rabbaniputrowi-alt/Mp3-player-Tamagothci-Companion/Tamagotchi Code/Tamagotchi Bee/previews/contact_sheet.png

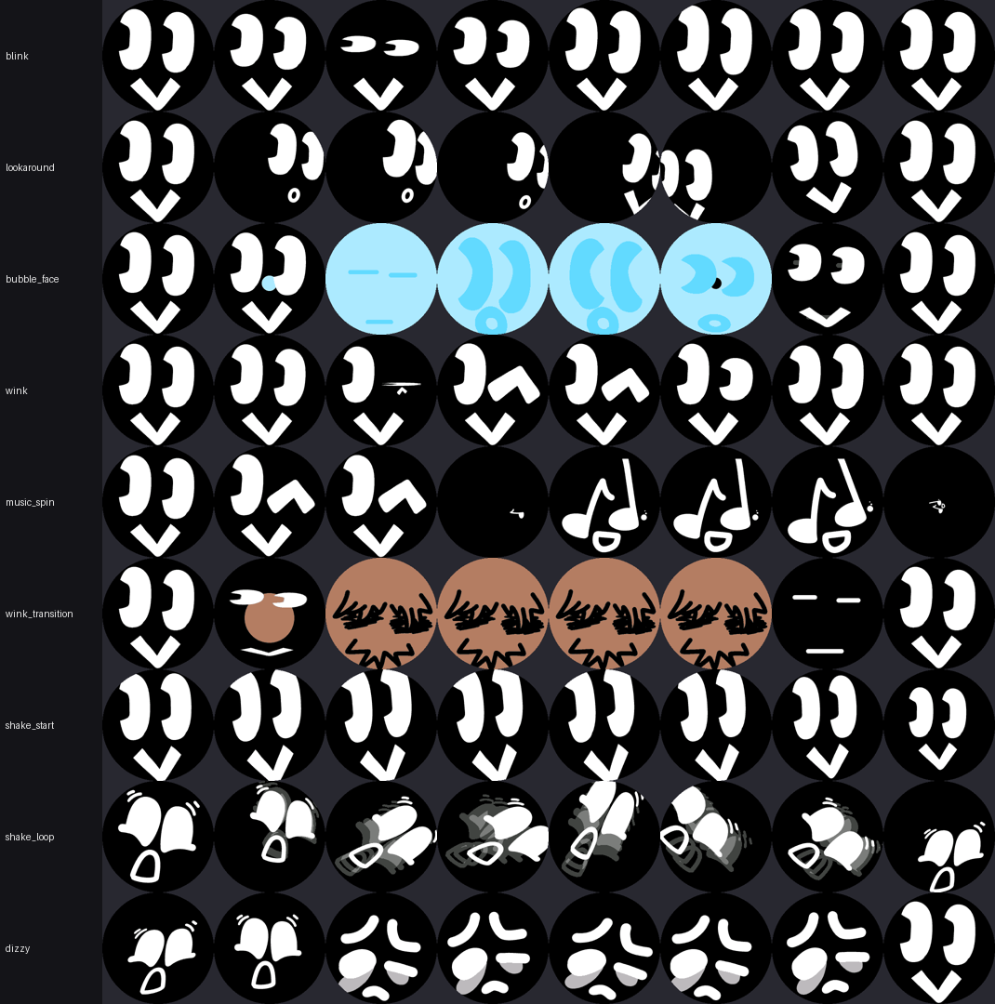
Tamagotchi Code/Tamagotchi Bee/previews/contact_sheet.png
