rabbaniputrowi-alt/Mp3-player-Tamagothci-Companion/Tamagotchi Code/TFT_folder/Spinning Disc/covers/Black_Parade.jpg

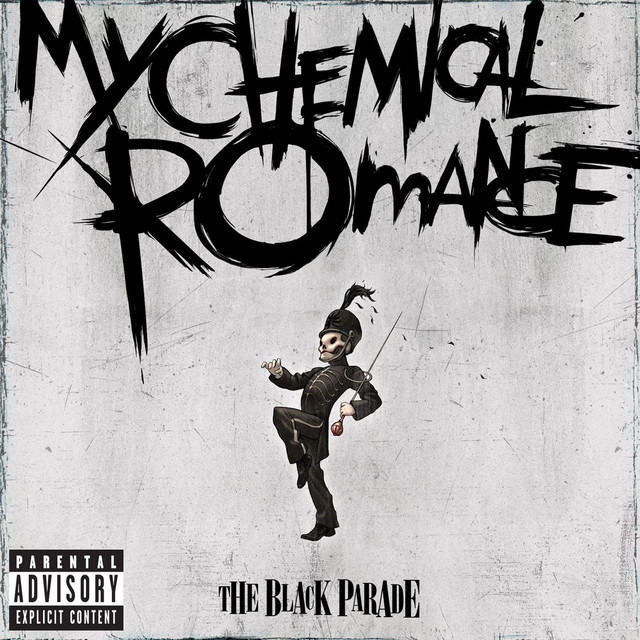
Tamagotchi Code/TFT_folder/Spinning Disc/covers/Black_Parade.jpg
