rabbaniputrowi-alt/Mp3-player-Tamagothci-Companion/Tamagotchi Code/TFT_folder/Spinning Disc/covers/Sweet_Revenge.jpg

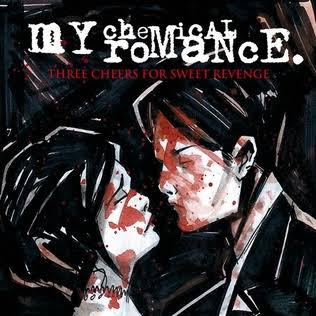
Tamagotchi Code/TFT_folder/Spinning Disc/covers/Sweet_Revenge.jpg
