rabbaniputrowi-alt/Mp3-player-Tamagothci-Companion/tools/Pet_Pipeline/clips/Penguin.gif

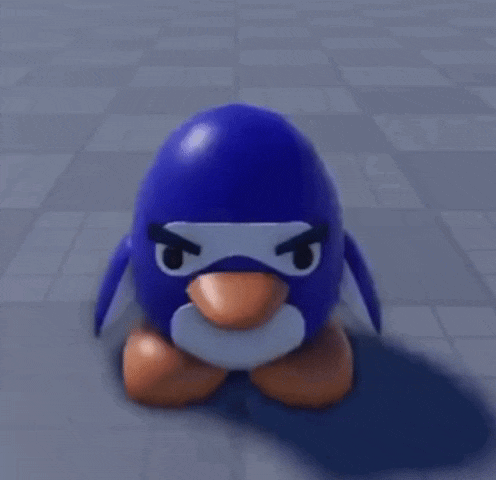
tools/Pet_Pipeline/clips/Penguin.gif
