rabbaniputrowi-alt/Mp3-player-Tamagothci-Companion/tools/previews/contact_sheet.png

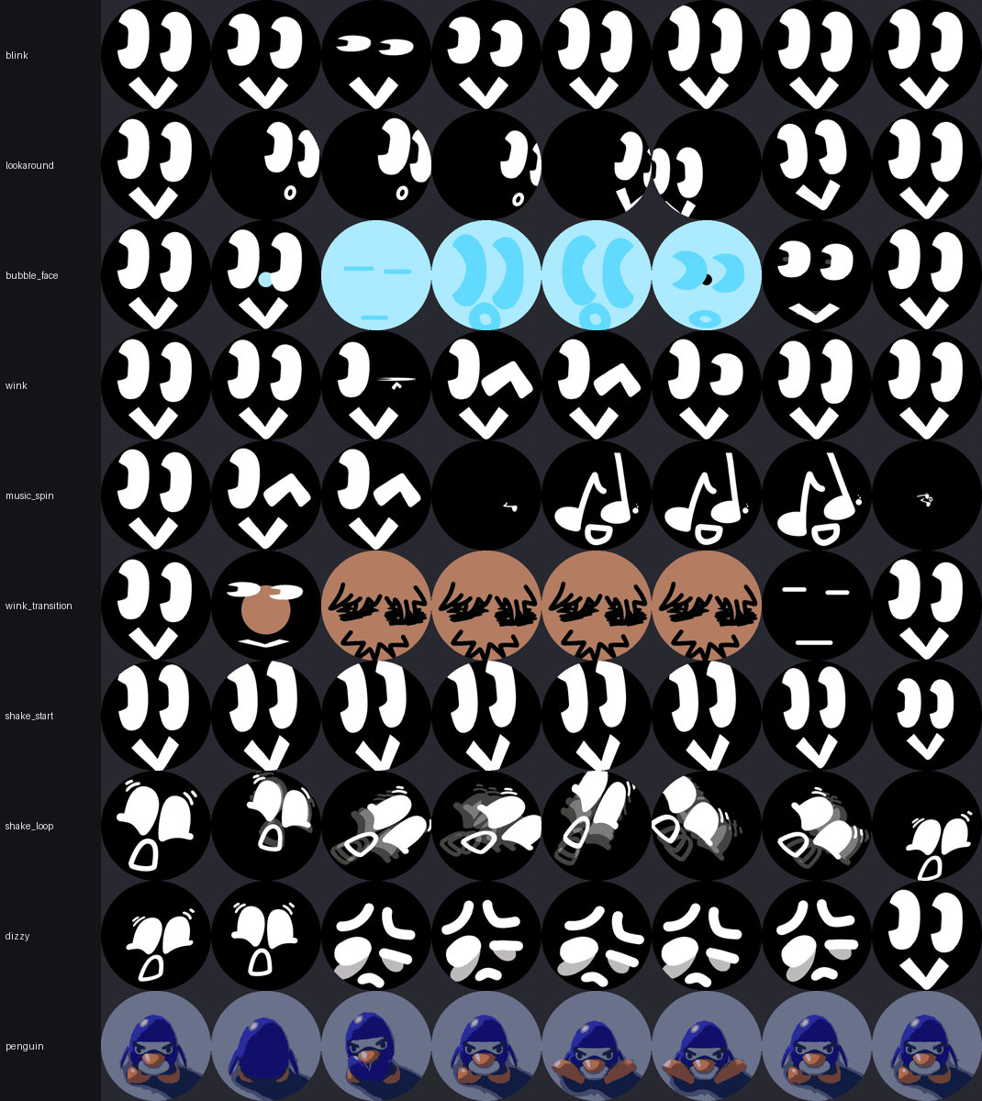
tools/previews/contact_sheet.png
