rabbaniputrowi-alt/Mp3-player-Tamagothci-Companion/tools/previews/shake_start.gif

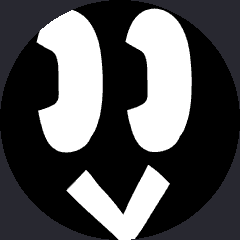
tools/previews/shake_start.gif
