rabbaniputrowi-alt/Mp3-player-Tamagothci-Companion/tools/Spinning Disc/covers/AlYankovic.jpg

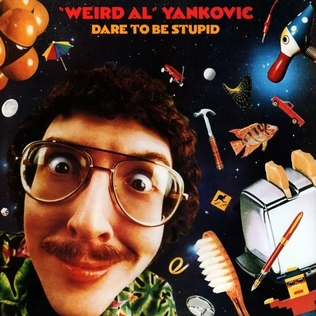
tools/Spinning Disc/covers/AlYankovic.jpg
