rabbaniputrowi-alt/Mp3-player-Tamagothci-Companion/tools/Spinning Disc/covers/bunii.jpg

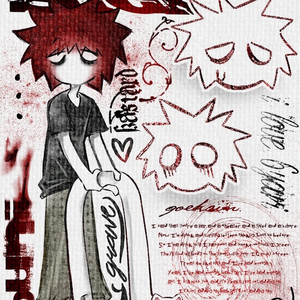
tools/Spinning Disc/covers/bunii.jpg
