rabbaniputrowi-alt/Mp3-player-Tamagothci-Companion/BOM.csv

Ref | Part | Value/Package | Qty per device | Order qty | Unit price USD | Order cost USD | Status | Vendor | URL | Notes
U1 | Waveshare RP2040-Zero | castellated module | 1 | 0 | 3.99 | 0.00 | owned | Waveshare | https://www.waveshare.com/rp2040-zero.htm | From the breadboard prototype
U2 | DFPlayer Mini MP3 module | 16-pin module, microSD slot | 1 | 0 | 5.90 | 0.00 | owned | DFRobot | https://www.dfrobot.com/product-1121.html | Clone in use; price is the genuine DFR0299
U3 | GY-521 MPU6050 breakout | 21 x 16 mm, 8 pins | 1 | 0 | 6.99 | 0.00 | owned | ShillehTek | https://shillehtek.com/products/shillehtek-mpu-6050-module-gy-521-module-unsoldered-version
DISP1 | GC9A01 1.28in round TFT module | 240x240 SPI, 7 pins, no backlight pin | 1 | 0 | 7.95 | 0.00 | owned | ProtoSupplies | https://protosupplies.com/?p=15523 | Wired to J4 pads; header removed, pins clipped
J1 | LiPo 3.7 V 1200 mAh 103040 | 40 x 30 x 10 mm pouch | 1 | 0 | 8.99 | 0.00 | owned | eBay | https://www.ebay.com/itm/111861172398 | Wired to J1 pads
SD1 | microSD card | 8 GB (2-32 GB works) | 1 | 0 | 14.00 | 0.00 | owned | RobotShop | https://www.robotshop.com/products/8-gb-microsd-card
J3 | PJ-307 3.5 mm TRS jack | XKB PJ-307N5, LCSC C692542 | 1 | 0 | 0.1937 | 0.00 | owned | LCSC | https://www.lcsc.com/product-detail/C692542.html | Sits in the board slot, wired to J3 pads
WIRE | Hookup wire | 28-30 AWG stranded, about 50 cm | 1 | 0 | 0 | 0.00 | owned | - |  | Display, battery and jack leads; from the breadboard kit
U4 | TP4056 Li-ion charger | ESOP-8, LCSC C16581 | 1 | 1 | 0.0893 | 0.09 | buy | LCSC | https://www.lcsc.com/product-detail/C16581.html
U5 | DW01A battery protection | SOT-23-6, LCSC C2927799 | 1 | 1 | 0.026 | 0.03 | buy | LCSC | https://www.lcsc.com/product-detail/C2927799.html
Q1 | 8205A dual N-MOSFET | TSSOP-8, LCSC C7499846 | 1 | 1 | 0.0195 | 0.02 | buy | LCSC | https://www.lcsc.com/product-detail/C7499846.html | TSSOP-8 version of FS8205A
D1 | SS14 Schottky diode | SMA, LCSC C83852 | 1 | 1 | 0.1234 | 0.12 | buy | LCSC | https://www.lcsc.com/product-detail/C83852.html
J5 | USB-C receptacle 6P GCT USB4125-GF-A | LCSC C3151650 | 1 | 1 | 0.5596 | 0.56 | buy | LCSC | https://www.lcsc.com/product-detail/C3151650.html
SW5 | Slide switch C&K OS102011MA1QN1 (POWER) | SPDT right angle THT, LCSC C226259 | 1 | 1 | 0.5969 | 0.60 | buy | LCSC | https://www.lcsc.com/product-detail/C226259.html
R1,R8 | Resistor 1k 1% | 0805, LCSC C17513 | 2 | 20 | 0.0019 | 0.04 | buy | LCSC | https://www.lcsc.com/product-detail/C17513.html
R2,R3 | Resistor 100k 1% | 0805, LCSC C17407 | 2 | 20 | 0.0014 | 0.03 | buy | LCSC | https://www.lcsc.com/product-detail/C17407.html | Battery sense divider
R4,R5 | Resistor 5.1k 1% | 0805, LCSC C27834 | 2 | 20 | 0.0028 | 0.06 | buy | LCSC | https://www.lcsc.com/product-detail/C27834.html | USB-C CC
R6 | Resistor 2k 1% | 0805, LCSC C17604 | 1 | 20 | 0.002 | 0.04 | buy | LCSC | https://www.lcsc.com/product-detail/C17604.html | TP4056 PROG, about 580 mA
R7 | Resistor 100R 1% | 0805, LCSC C17408 | 1 | 20 | 0.0024 | 0.05 | buy | LCSC | https://www.lcsc.com/product-detail/C17408.html
C1,C2,C4,C5 | Capacitor 10uF 25V X5R | 0805, LCSC C15850 | 4 | 20 | 0.0241 | 0.48 | buy | LCSC | https://www.lcsc.com/product-detail/C15850.html
C3,C6 | Capacitor 100nF 50V X7R | 0805, LCSC C49678 | 2 | 20 | 0.0086 | 0.17 | buy | LCSC | https://www.lcsc.com/product-detail/C49678.html
HDR | Pin header 1x40 2.54 mm | THT, LCSC C2337 | 1 | 1 | 0.0857 | 0.09 | buy | LCSC | https://www.lcsc.com/product-detail/C2337.html | Leads for DFPlayer and GY-521 if they come without pins
HW2 | M2 heat-set insert, brass | M2 x 5 x 3.5 mm, LCSC C51938897 | 4 | 10 | 0.0131 | 0.13 | buy | LCSC | https://www.lcsc.com/product-detail/C51938897.html | Case bosses have 3.2 mm holes, 5.3 mm deep
SW1,SW3,SW4 | Tactile switch C&K PTS645VL58-2 LFS (PREV, NEXT, MENU) | 6 mm right angle THT | 3 | 3 | 0.44 | 1.32 | buy | DigiKey | https://www.digikey.com/en/products/detail/c-k/PTS645VL58-2-LFS/1146769 | Must be this part: the case caps are fitted to its actuator
SW2 | Tactile switch C&K PTS645SL50-2 LFS (PLAY) | 6x6 mm THT, 5.0 mm tall | 1 | 1 | 0.28 | 0.28 | buy | DigiKey | https://www.digikey.com/en/products/detail/c-k/PTS645SL50-2-LFS/1146781 | 5.0 mm height matches the PLAY cap
HW1 | M2 x 12 mm socket head cap screw, stainless | pack of 10, 4 used | 1 | 1 | 1.44 | 1.44 | buy | RobotShop | https://www.robotshop.com/products/3d-printing-canada-usa-stainless-steel-metric-thread-socket-head-cap-screw-10-pack-m2-12-mm
PCB | Carrier PCB v2, 2 layers, 1.2 mm, 83 x 83 mm | JLCPCB, 5 boards minimum | 1 | 1 | 2.00 | 2.00 | buy | JLCPCB | https://jlcpcb.com/quote | $2 for 5 two-layer boards up to 100 x 100 mm; check the 1.2 mm option in the quote
CASE | Case v5 print: front shell, back shell, 4 caps | about 32 cm3 of material | 1 | 1 | 12.00 | 12.00 | buy (estimate) | JLC3DP | https://jlc3dp.com/3d-printing-quote | Estimate; quote the STLs in CAD/
SHIP-JLC | Shipping, JLCPCB (PCB + case print in one parcel) | to Jakarta | 1 | 1 | 8.00 | 8.00 | buy (estimate) | JLCPCB | https://jlcpcb.com/quote | Estimate, Global Standard Direct Line
SHIP-LCSC | Shipping, LCSC | to Jakarta | 1 | 1 | 8.00 | 8.00 | buy (estimate) | LCSC | https://www.lcsc.com | Estimate
SHIP-DK | Shipping, DigiKey | to Jakarta | 1 | 1 | 20.00 | 20.00 | buy (estimate) | DigiKey | https://www.digikey.com | Estimate
SHIP-RS | Shipping, RobotShop | to Jakarta | 1 | 1 | 10.00 | 10.00 | buy (estimate) | RobotShop | https://www.robotshop.com | Estimate
DUTY | Import duty and VAT | Indonesia | 1 | 1 | 5.00 | 5.00 | buy (estimate) | - |  | Estimate
HW3 | Split ring 22 mm (keychain loop), optional | 22 mm ID | 1 | 10 | 0.9 | 9.00 | optional | PetHardware | https://www.pethardware.com/en/split-rings/metal-key-ring-charm-5108/index.md | Minimum order 10; not counted in the totals
TOTAL | To buy (funding request), including shipping estimates |  |  |  |  | 70.54
TOTAL | Parts already owned (value) |  |  |  |  | 48.01
TOTAL | Full cost of one device (owned + to buy) |  |  |  |  | 118.55
