rabbaniputrowi-alt/Mp3-player-Tamagothci-Companion/CAD/stardance_v5_back_shell.stl

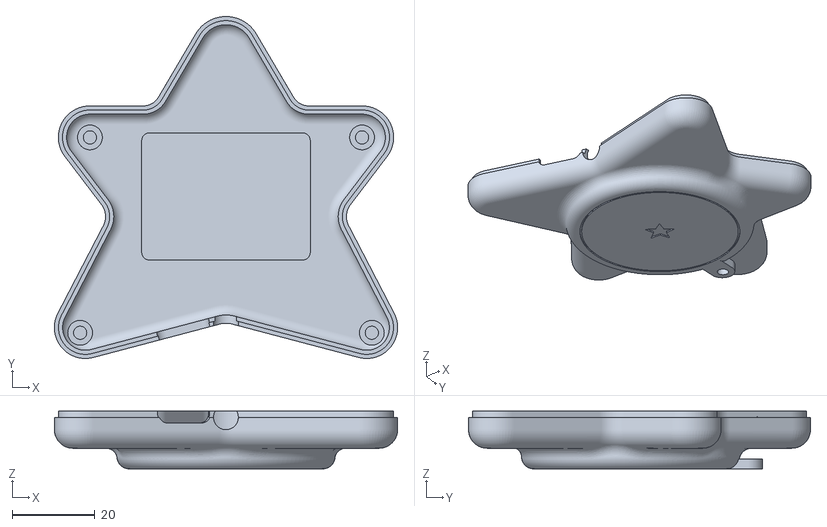
[picture p17: CAD file, 2026-11-05]
CAD/stardance_v5_back_shell.stl
83.1 x 82.8 x 14.0
