rabbaniputrowi-alt/Mp3-player-Tamagothci-Companion/CAD/stardance_v5_button_caps.step

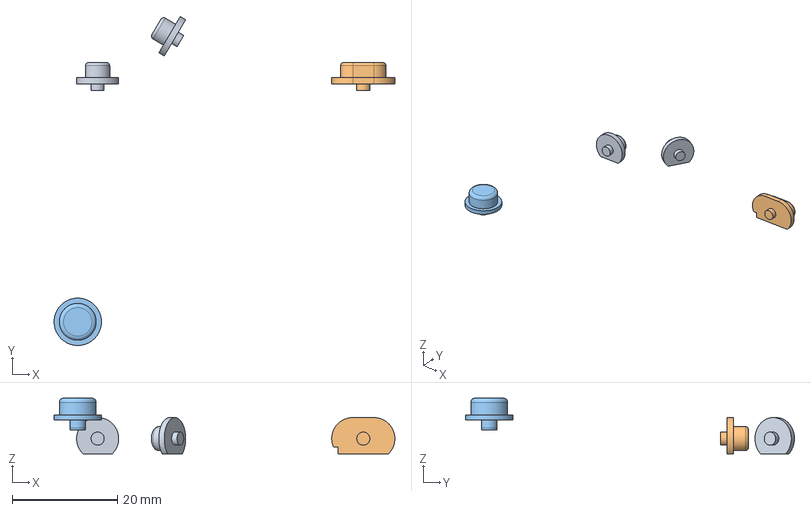
[picture p18: CAD file, 2026-11-05]
CAD/stardance_v5_button_caps.step
64.7 x 62.4 x 10.6 mm
