rabbaniputrowi-alt/Mp3-player-Tamagothci-Companion/CAD/stardance_v4_front_shell.step

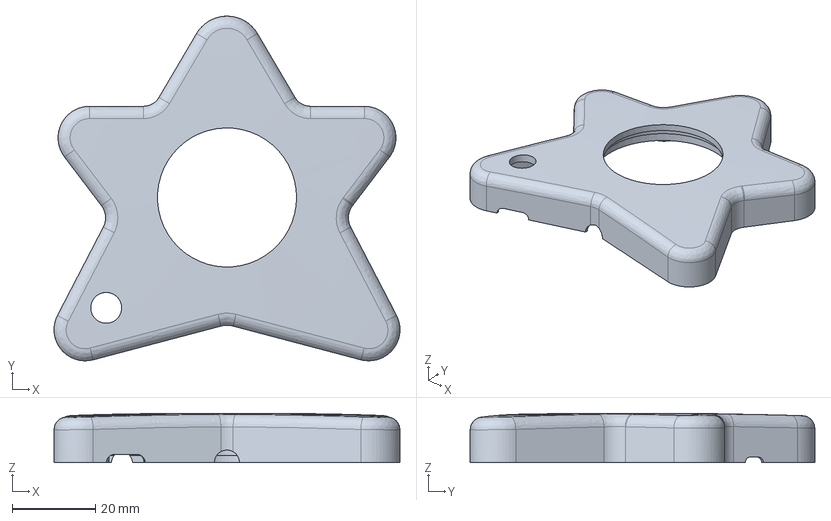
[picture p19: CAD file, 2026-10-30]
CAD/stardance_v4_front_shell.step
83.1 x 82.8 x 11.8 mm
