rabbaniputrowi-alt/Mp3-player-Tamagothci-Companion/(list of files, cad)

Other CAD files:
CAD/stardance_v5_button_caps.stl
