rabbaniputrowi-alt/Mp3-player-Tamagothci-Companion/(commit log)

2026-07-25 Added wiring.md for the prototype breadboard wiring
2026-07-28 Wiring update | changed input pins for buttons and dfplayer for more cleaner breadboard wiring
2026-07-31 planned to animate using one frame by splitting the init csv file and splitting it into sprites and animating those sprite
2026-08-02 Animation + button test
2026-08-02 wasnt satisfied with the first build. tweaked some changes to make it flow better
    pingpong to loop both affection animation
    mirror to mirror the lookinjg around animation
2026-08-02 Fixed a couple bugs
    [tamagotchi_eyes.ino]
2026-08-02 Moved a bunch of stuff
    [oled (1).csv]
2026-08-15 New modules and microcontroller wirings
2026-08-15 turns out u cant randomly put wires in convinient GPIO's; fixed them accordingly here
2026-09-22 Removed Vinyl Disc look
    - Removed Groves and vinyl disc aesthetic
    - Added and wrote an extra album cover
    - Album covers are fixated to playlist instead of individual songs
    - Added a switching playlist (just to test all 3 album covers switching and its animation)
2026-10-04 added more animations and synced its direction with MPU6050
    - Replaced the flat face look and made it more dynamic by making it look as if the face is planted on a ball/globe. So when it looks around it stretches itself accordingly
    - Replaced the intial look around with the more dynamic animation
    - Added a shaking animation: shake the lil guy and an animation of him bouncing all over the place followed with a dizzy animation
    - Bubble Bee face that pops up less often than the others
    Also change a couple things on the MP3 side!
    - Added a track.py builder so it could write new tracks in track.json to the playlist UI. (used alot of AI for this one)
    - Added more album covers because i love them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
2026-10-30 Ship prep: new chooser UI, battery monitor, docs and BOM
    Firmware
    - New playlist/track chooser (mini records, anti-aliased text, fonts,
    blurred backdrop), dual-core band drawing, DFPlayer BUSY-pin autoplay
    - Each view owns PREV/PLAY/NEXT (pet view no longer touches the music)
    - Default volume 15 of 30 (was 30) since the sketch autoplays at boot
    - PET_MOTION_DEBUG and UI_TIMING_DEBUG default to false
    - Battery module reads GP26 (100k/100k divider), logs to Serial every 10 s,
    no UI yet
    - DFPlayer error / SD card events logged on Serial (diagnostics only)
    - Not compiled or flash-tested in this session
    Docs and repo
    - README rewritten, wiring.md corrected (display SCL=GP14, SDA=GP15)
    - BOM.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
2026-10-30 Added PCB, CAD, designs, and README Update
    Added the CAD and Kicad PCB in their own respective folders whilst also adding images in README
2026-10-30 Shipping prep Revision
    Updated the README to include characters that were included. and imported .kicad_pro file and its schematics
2026-10-30 README REV FINAL
    used an older version of the CAD file so i updated that and also changing a couple stuff in the readme
2026-11-04 Case v5, full assembly STEP, PCB libraries, rebuilt BOM, wiring diagram
    - CAD: case v5 fitted to carrier PCB v2 (side buttons at switch height,
    USB-C opening, M2 insert bosses and screw columns, collar notch for NEXT),
    printable STLs, and stardance_assembly.step with every part. Build and
    fit-check scripts in CAD/source. v4 case files moved to Archive/case_v4.
    - PCB: custom footprint and symbol libraries with lib tables, 3D models
    for the modules; board file only gains model links (no electrical change).
    - BOM.csv rebuilt from the schematic with prices and shipping estimates.
    - docs/images: wiring diagram for the off-board wires and assembly renders.
